Akerasoft/AS-NROM-368/README.md

# AS-NROM-368
NES compatible mapper that gives nearly 46KB instead of 32KB.  Has the linear space of NROM so no bank swapping.

Begining byte is $4800 until $FFFF.  Called NROM-368.
Mapper 474 submapper 1.
