Akerasoft/AS-NROM-368/gerber/AS-NES-Mapper474-SM1-PTH-drl_map.dxf

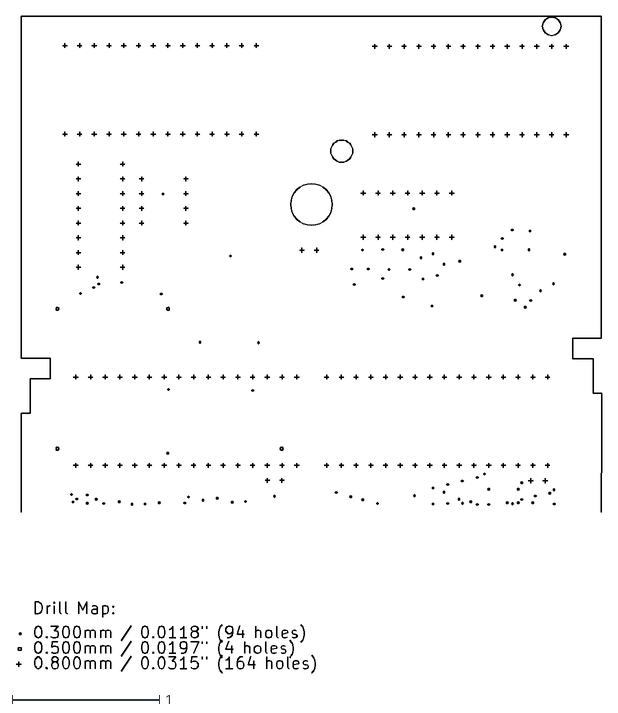
[picture p1: CAD file, 2023-06-27]
gerber/AS-NES-Mapper474-SM1-PTH-drl_map.dxf
3.97 x 4.46
