Akerasoft/AS-NROM-368/step files/AS-NES-Mapper474.step

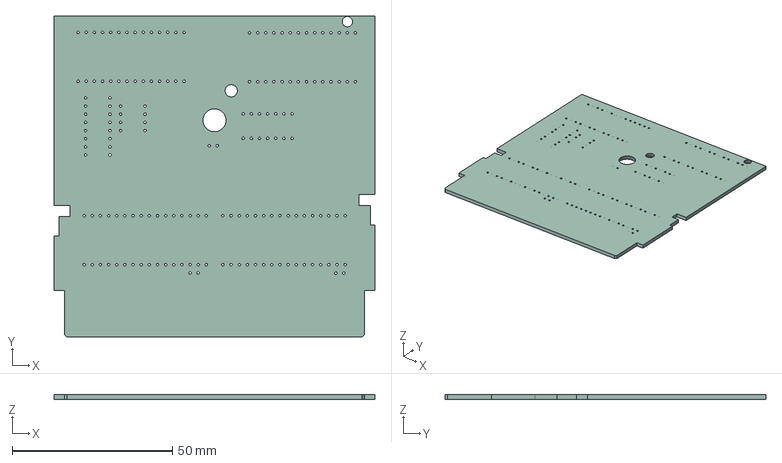
[picture p2: CAD file, 2023-06-27]
step files/AS-NES-Mapper474.step
100.0 x 100.0 x 1.58 mm
