Akerasoft/AS-NROM-368/gerber/AS-NES-Mapper474-SM1-NPTH-drl_map.dxf

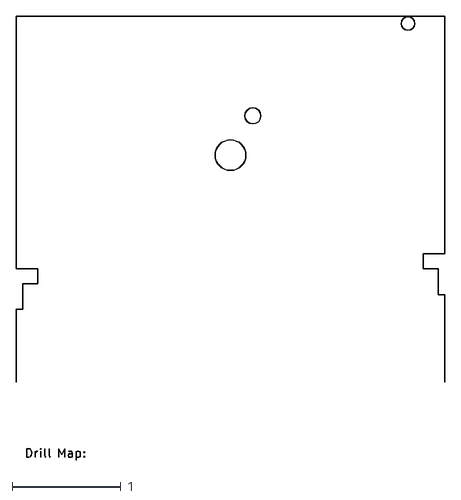
[picture p3: CAD file, 2023-06-27]
gerber/AS-NES-Mapper474-SM1-NPTH-drl_map.dxf
3.94 x 4.08
