Akerasoft/AS-NROM-368/schematics/schematic.pdf

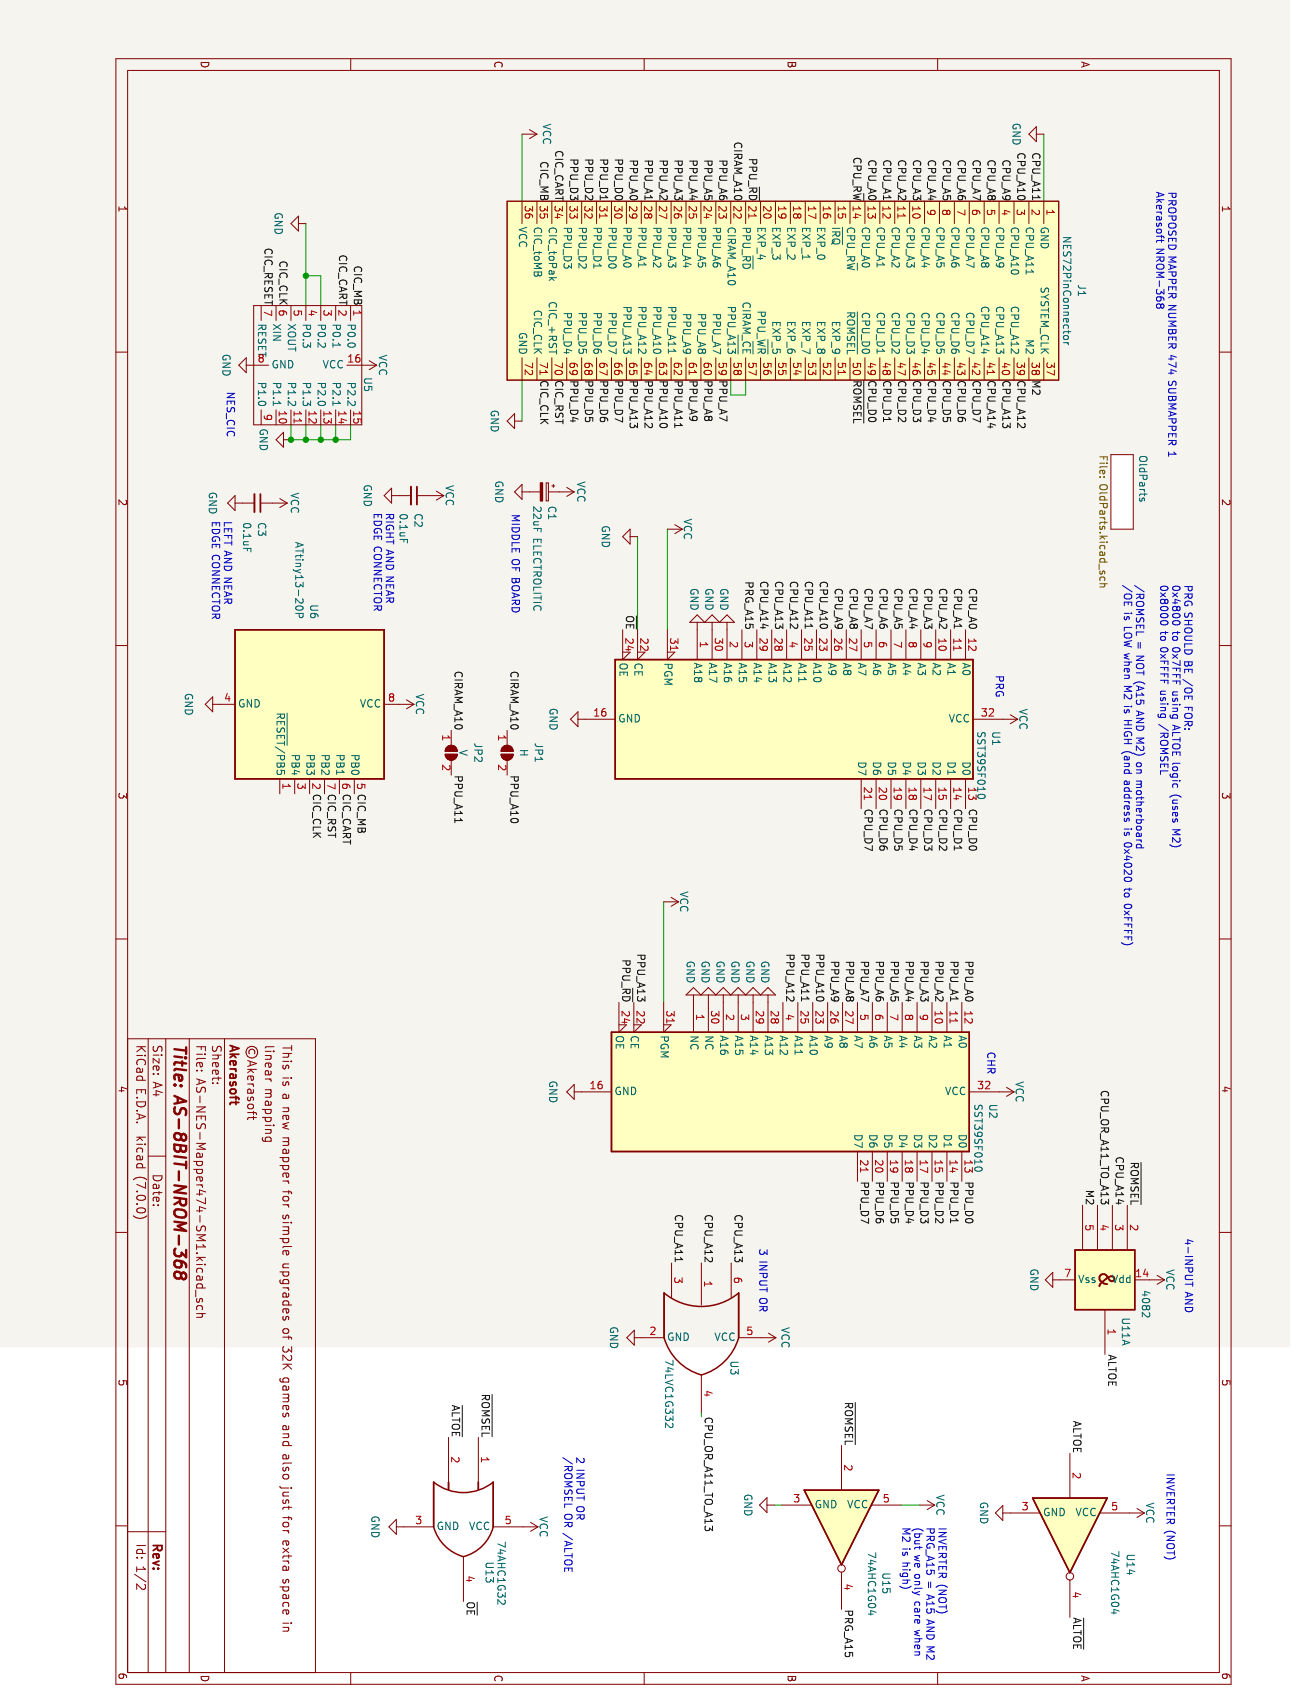
[picture p4: page 1]

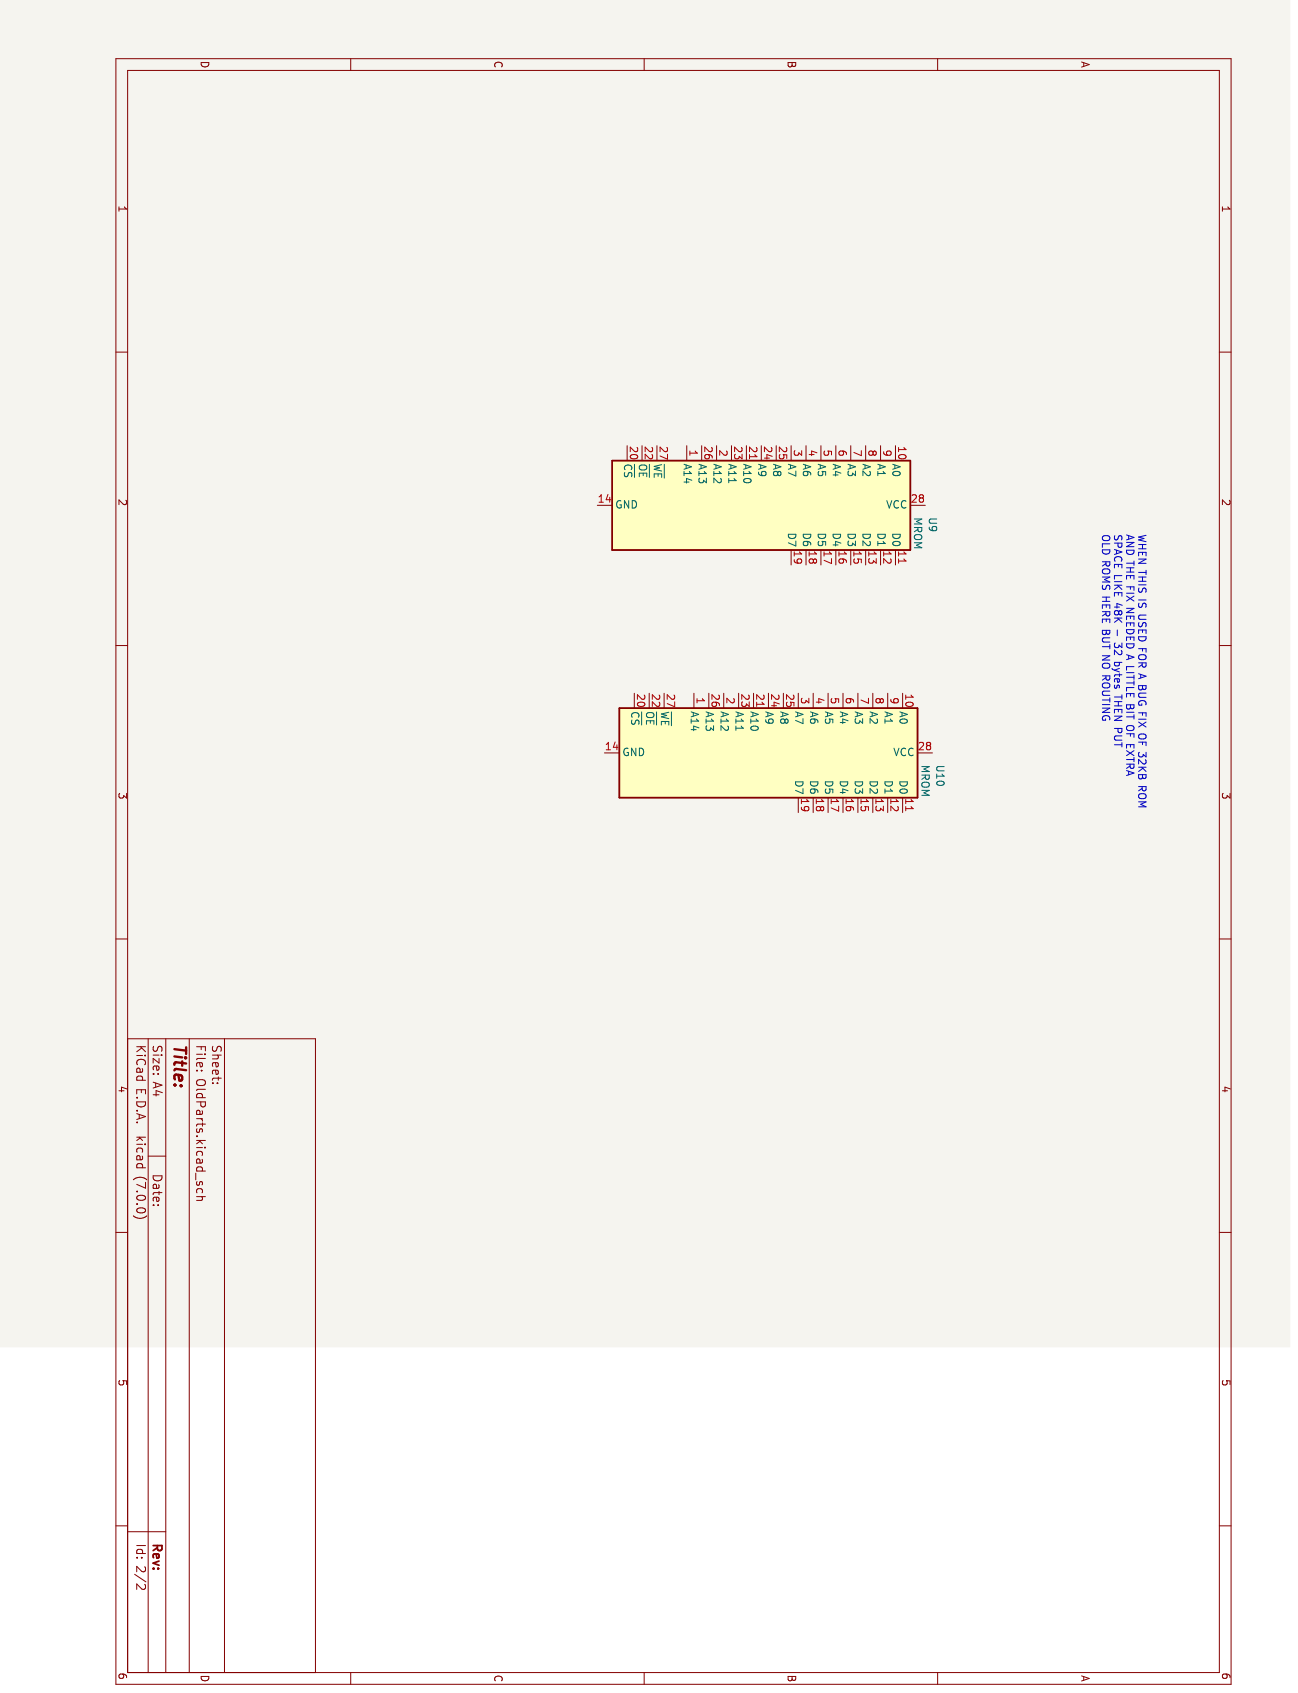
[picture p5: page 2]
