Akerasoft/AS-NROM-368/kicad project files/AS-NES-Mapper474-SM1/AS-NES-Mapper474-SM1.kicad_pcb

## KiCad design kicad project files/AS-NES-Mapper474-SM1/AS-NES-Mapper474-SM1.kicad_pcb (2023-06-27)

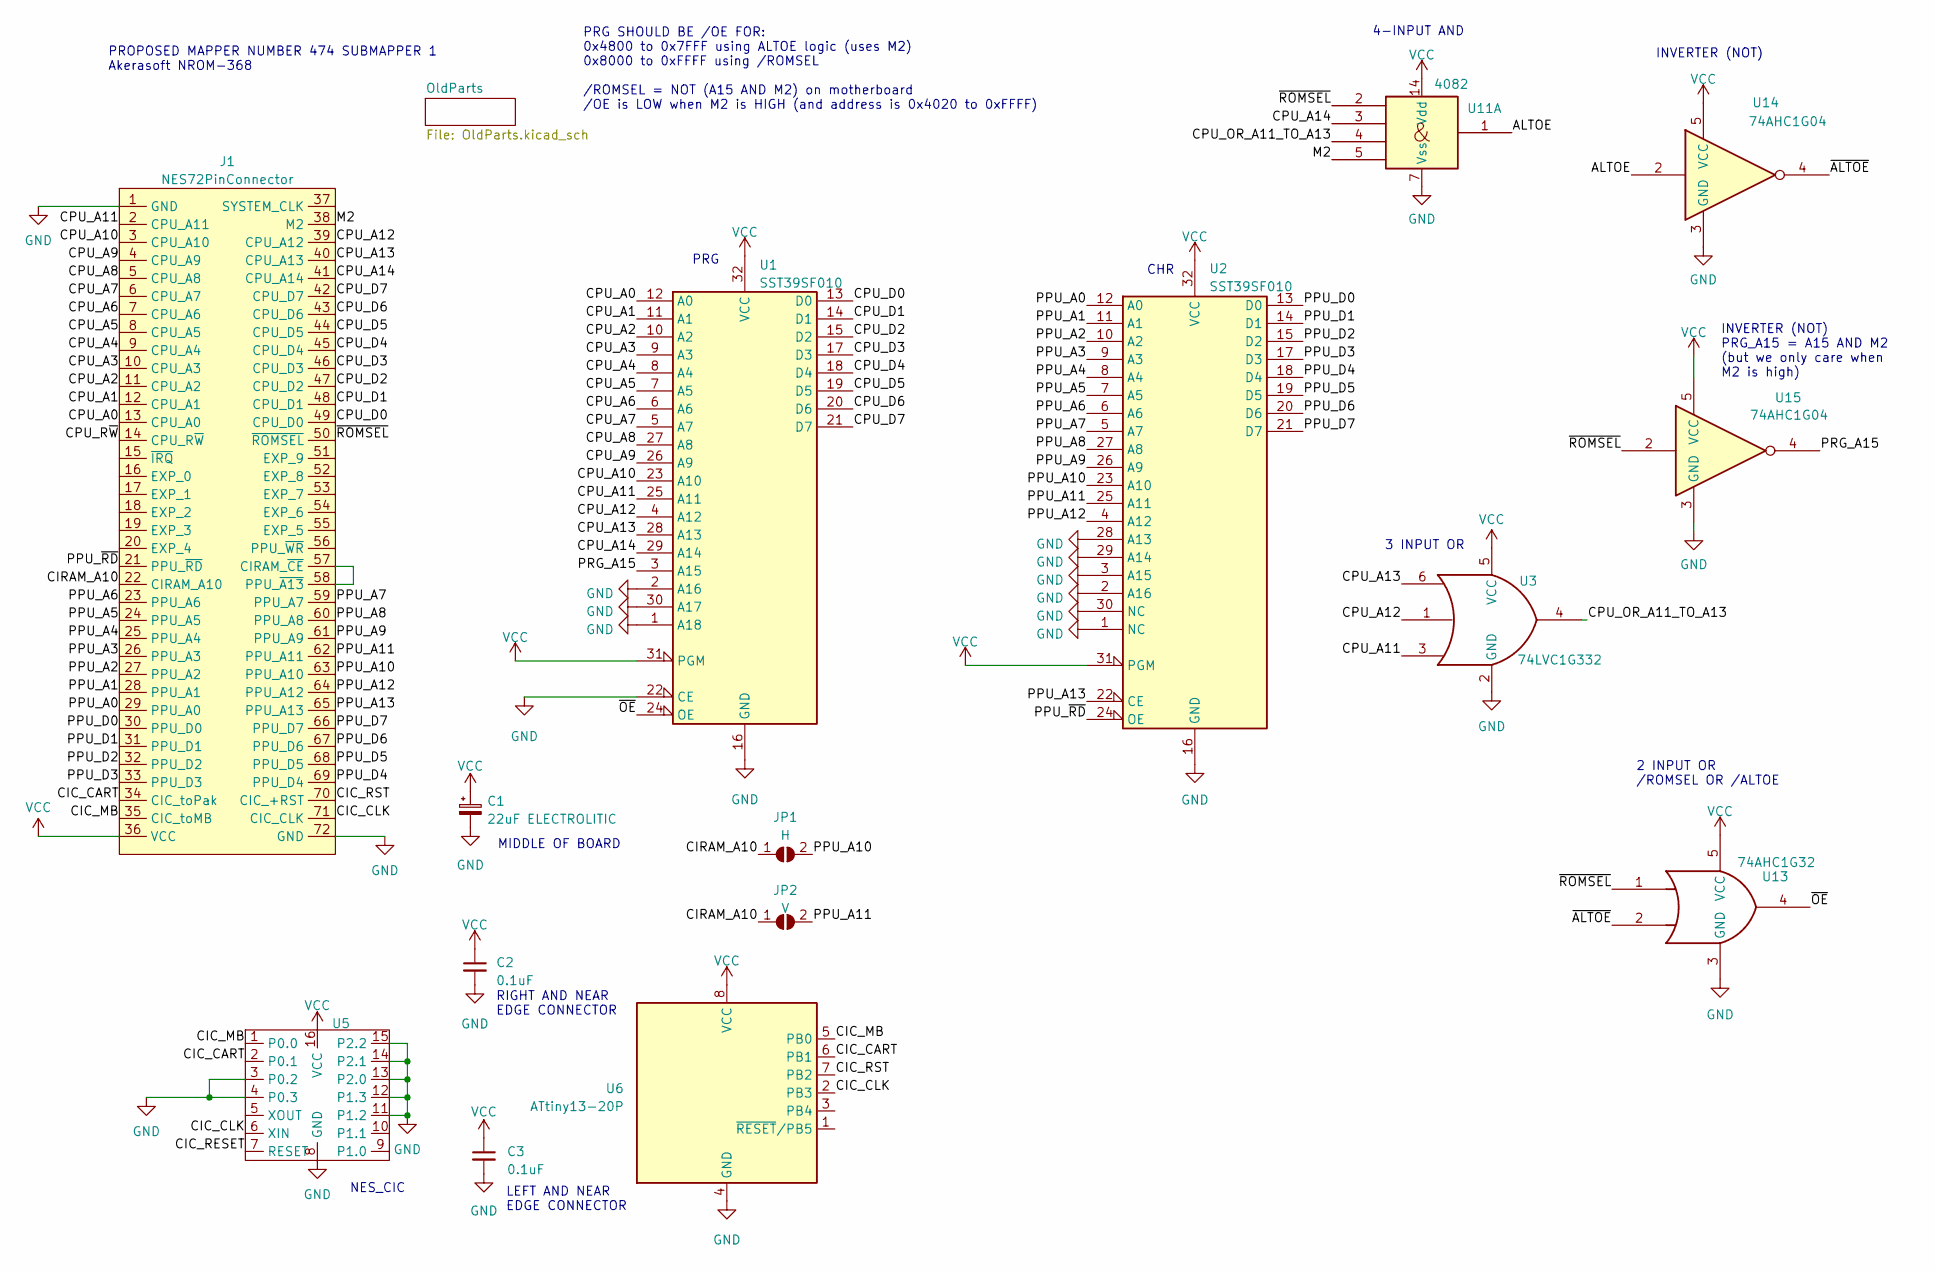
[picture p6: schematic AS-NES-Mapper474-SM1.kicad_sch, AS-8BIT-NROM-368]

Parts:
C1: 22uF ELECTROLITIC; CP_Radial_D5.0mm_P2.50mm
C2, C3: 0.1uF; C_Disc_D3.0mm_W1.6mm_P2.50mm
J1: NES72PinConnector; NES72PinEdgeConnector2
JP1: H; SolderJumper-2_P1.3mm_Open_Pad1.0x1.5mm
JP2: V; SolderJumper-2_P1.3mm_Open_Pad1.0x1.5mm
U1, U2: SST39SF010; DIP-32_W15.24mm
U3: 74LVC1G332; SOT-886
U5: DIP-16_W7.62mm
U6: ATtiny13-20P; DIP-8_W7.62mm
U11: 4082; DIP-14_W7.62mm
U13: 74AHC1G32; SOT-23-5
U14, U15: 74AHC1G04; SOT-23-5

Connections:
/ALTOE: U11.1, U14.2
/CIC_CART: J1.34 (CIC_toPak), U5.2 (P0.1), U6.6 (PB1)
/CIC_CLK: J1.71 (CIC_CLK), U5.6 (XIN), U6.2 (PB3)
/CIC_MB: J1.35 (CIC_toMB), U5.1 (P0.0), U6.5 (PB0)
/CIC_RESET: U5.7 (RESET)
/CIC_RST: J1.70 (CIC_+RST), U6.7 (PB2)
/CIRAM_A10: J1.22 (CIRAM_A10), JP1.1 (A), JP2.1 (A)
/CPU_A0: J1.13 (CPU_A0), U1.12 (A0)
/CPU_A1: J1.12 (CPU_A1), U1.11 (A1)
/CPU_A2: J1.11 (CPU_A2), U1.10 (A2)
/CPU_A3: J1.10 (CPU_A3), U1.9 (A3)
/CPU_A4: J1.9 (CPU_A4), U1.8 (A4)
/CPU_A5: J1.8 (CPU_A5), U1.7 (A5)
/CPU_A6: J1.7 (CPU_A6), U1.6 (A6)
/CPU_A7: J1.6 (CPU_A7), U1.5 (A7)
/CPU_A8: J1.5 (CPU_A8), U1.27 (A8)
/CPU_A9: J1.4 (CPU_A9), U1.26 (A9)
/CPU_A10: J1.3 (CPU_A10), U1.23 (A10)
/CPU_A11: J1.2 (CPU_A11), U1.25 (A11), U3.3
/CPU_A12: J1.39 (CPU_A12), U1.4 (A12), U3.1
/CPU_A13: J1.40 (CPU_A13), U1.28 (A13), U3.6
/CPU_A14: J1.41 (CPU_A14), U1.29 (A14), U11.3
/CPU_D0: J1.49 (CPU_D0), U1.13 (D0)
/CPU_D1: J1.48 (CPU_D1), U1.14 (D1)
/CPU_D2: J1.47 (CPU_D2), U1.15 (D2)
/CPU_D3: J1.46 (CPU_D3), U1.17 (D3)
/CPU_D4: J1.45 (CPU_D4), U1.18 (D4)
/CPU_D5: J1.44 (CPU_D5), U1.19 (D5)
/CPU_D6: J1.43 (CPU_D6), U1.20 (D6)
/CPU_D7: J1.42 (CPU_D7), U1.21 (D7)
/CPU_OR_A11_TO_A13: U3.4, U11.4
/CPU_R~W: J1.14 (CPU_R~W)
/M2: J1.38 (M2), U11.5
/PPU_A0: J1.29 (PPU_A0), U2.12 (A0)
/PPU_A1: J1.28 (PPU_A1), U2.11 (A1)
/PPU_A2: J1.27 (PPU_A2), U2.10 (A2)
/PPU_A3: J1.26 (PPU_A3), U2.9 (A3)
/PPU_A4: J1.25 (PPU_A4), U2.8 (A4)
/PPU_A5: J1.24 (PPU_A5), U2.7 (A5)
/PPU_A6: J1.23 (PPU_A6), U2.6 (A6)
/PPU_A7: J1.59 (PPU_A7), U2.5 (A7)
/PPU_A8: J1.60 (PPU_A8), U2.27 (A8)
/PPU_A9: J1.61 (PPU_A9), U2.26 (A9)
/PPU_A10: J1.63 (PPU_A10), JP1.2 (B), U2.23 (A10)
/PPU_A11: J1.62 (PPU_A11), JP2.2 (B), U2.25 (A11)
/PPU_A12: J1.64 (PPU_A12), U2.4 (A12)
/PPU_A13: J1.65 (PPU_A13), U2.22 (CE)
/PPU_D0: J1.30 (PPU_D0), U2.13 (D0)
/PPU_D1: J1.31 (PPU_D1), U2.14 (D1)
/PPU_D2: J1.32 (PPU_D2), U2.15 (D2)
/PPU_D3: J1.33 (PPU_D3), U2.17 (D3)
/PPU_D4: J1.69 (PPU_D4), U2.18 (D4)
/PPU_D5: J1.68 (PPU_D5), U2.19 (D5)
/PPU_D6: J1.67 (PPU_D6), U2.20 (D6)
/PPU_D7: J1.66 (PPU_D7), U2.21 (D7)
/PPU_~RD: J1.21 (PPU_~RD), U2.24 (OE)
/PRG_A15: U1.3 (A15), U15.4
/~ALTOE: U13.2, U14.4
/~OE: U1.24 (OE), U13.4
/~ROMSEL: J1.50 (~ROMSEL), U11.2, U13.1, U15.2
GND: C1.2, C2.2, C3.2, J1.1 (GND), J1.72 (GND), U1.1 (A18), U1.2 (A16), U1.16 (GND), U1.22 (CE), U1.30 (A17), U2.1 (NC), U2.2 (A16), U2.3 (A15), U2.16 (GND), U2.28 (A13), U2.29 (A14), U2.30 (NC), U3.2 (GND), U5.3 (P0.2), U5.4 (P0.3), U5.8 (GND), U5.11 (P1.2), U5.12 (P1.3), U5.13 (P2.0), U5.14 (P2.1), U5.15 (P2.2), U6.4 (GND), U11.7 (Vss), U13.3 (GND), U14.3 (GND), U15.3 (GND)
unnamed: J1.57 (CIRAM_~CE), J1.58 (PPU_~A13)
VCC: C1.1, C2.1, C3.1, J1.36 (VCC), U1.31 (PGM), U1.32 (VCC), U2.31 (PGM), U2.32 (VCC), U3.5 (VCC), U5.16 (VCC), U6.8 (VCC), U11.14 (Vdd), U13.5 (VCC), U14.5 (VCC), U15.5 (VCC)

Notes on the sheet:
PROPOSED MAPPER NUMBER 474 SUBMAPPER 1 Akerasoft NROM-368
4-INPUT AND
3 INPUT OR
2 INPUT OR /ROMSEL OR /ALTOE
RIGHT AND NEAR EDGE CONNECTOR
PRG SHOULD BE /OE FOR: 0x4800 to 0x7FFF using ALTOE logic (uses M2) 0x8000 to 0xFFFF using /ROMSEL /ROMSEL = NOT (A15 AND M2) on motherboard /OE is LOW when M2 is HIGH (and address is 0x4020 to 0xFFFF)
INVERTER (NOT) PRG_A15 = A15 AND M2 (but we only care when M2 is high)
CHR
MIDDLE OF BOARD
LEFT AND NEAR EDGE CONNECTOR
NES_CIC
PRG
INVERTER (NOT)

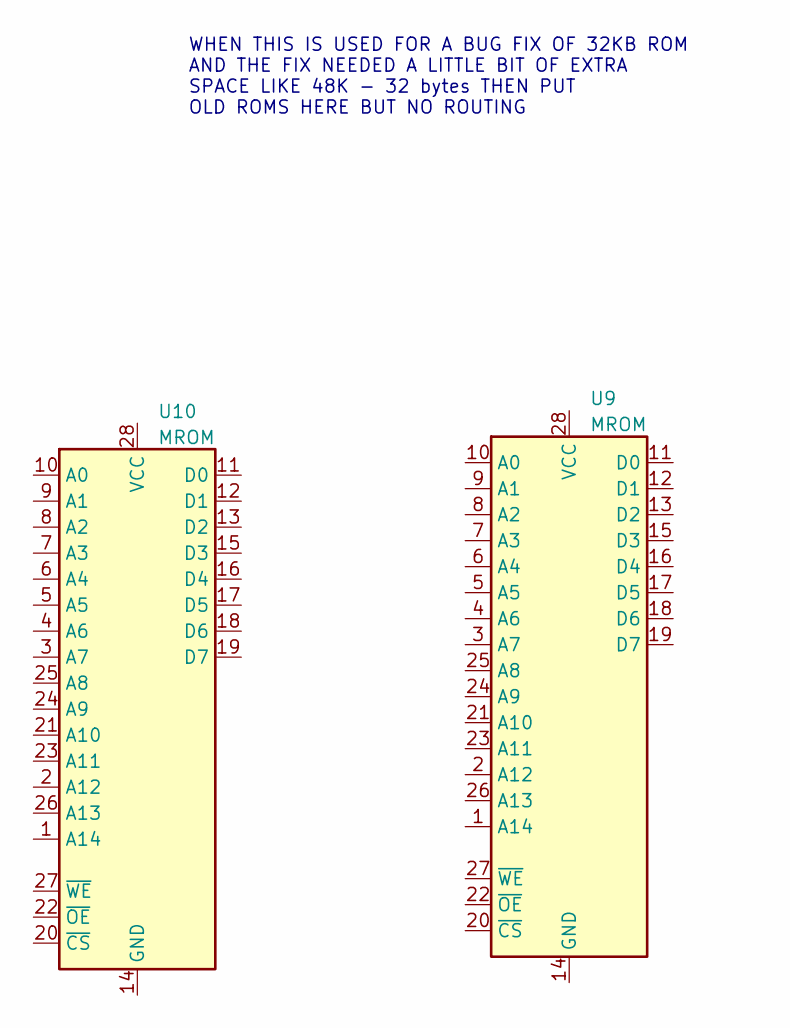
[picture p7: schematic OldParts.kicad_sch]

Parts:
U9, U10: MROM; DIP-28_W15.24mm

Notes on the sheet:
WHEN THIS IS USED FOR A BUG FIX OF 32KB ROM AND THE FIX NEEDED A LITTLE BIT OF EXTRA SPACE LIKE 48K - 32 bytes THEN PUT OLD ROMS HERE BUT NO ROUTING

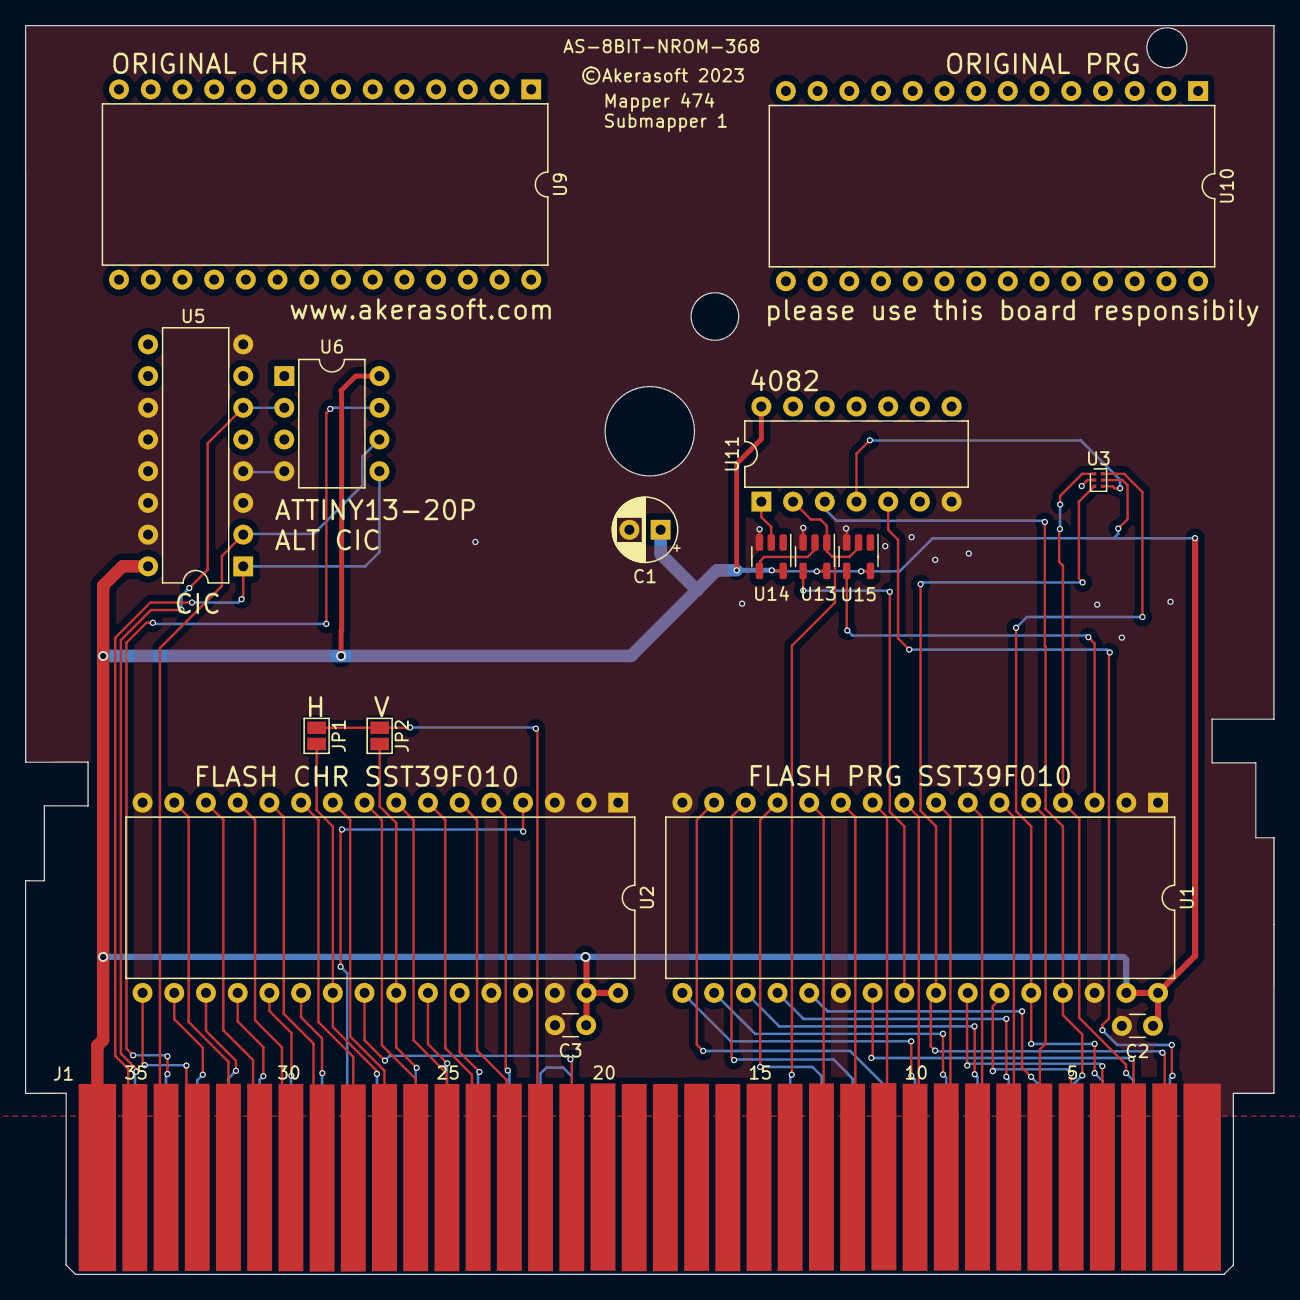
[picture p8: board AS-NES-Mapper474-SM1.kicad_pcb from above]

Board: 2 copper layers, 100.0 x 100.0 mm, 17 parts (0 on the bottom side), 61 nets.
