Akerasoft/AS-NROM-368/(notices)

Notices in the files:
kicad project files/AS-NES-Mapper474-SM1/AS-NES-Mapper474-SM1.kicad_sch:
©Akerasoft
kicad project files/AS-NES-Mapper474-SM1/AS-NES-Mapper474-SM1.kicad_pcb:
©Akerasoft 2023
